PSenfft/pv_test_station/doc/partslist.md

# Parts list
- [ ] 1x (Adafruit Feather M0 LoRa Radio - 433MHz)[https://www.mouser.de/account/orders/detail?qs=Sn2QTPuoay%252BUEfD1VQ4ZfDkVjOmp3iWeccA1x4dP3mE%3d]
- [ ] 1x (Adafruit LoRa Radio Bonnet - 433MHz)[https://www.mouser.de/ProductDetail/485-4075]
- [ ] 1x Raspberry Pi 4
- [ ] 1x Current Sensor [CT426-HSN830DR](https://www.mouser.de/ProductDetail/462-CT426-HSN830DR)
- [ ] 2x [MCP9808 Temp Sensor Breakout Adafruit](https://www.mouser.de/ProductDetail/485-1782)
- [ ] 47K Resistor
- [ ] 3,3K Resistor
- [ ] 1uF capacitor (X5R)
- [ ] (Adafruit DS3231 Precision RTC)[https://www.mouser.de/ProductDetail/485-5188]
- [ ] I2C extender (LTC4311) [https://www.mouser.de/ProductDetail/485-4756]
- [ ] (433MHz Antenna db station) [https://www.mouser.de/ProductDetail/538-204287-0100]
- [ ] (433MHz Antenna dataminer)[https://www.mouser.de/ProductDetail/712-ANT-433-PW-QWUFL]
- [ ] (MPPT Controller (Off-Grid))[https://www.offgridtec.com/victron-smartsolar-mppt-75-15-15a-12v-24v-solar-laderegler.html]
- [ ] Dummyload ~500W immersion heaters
- [ ] (Relais 24V 20A) [https://www.digikey.de/de/products/detail/american-zettler/AZ576-1A-5DE/14307551]
- [ ] (Step Down DC/DC) [https://www.digikey.de/de/products/detail/dfrobot/DFR0571/9559261]
- [ ] PCB to Wire connector panel side min 43V 14A (Phoenic Contact 277-1579-ND)[https://www.digikey.de/de/products/detail/phoenix-contact/1017505/9346606]
- [ ] PCB to Wire connector load side min 24V 21A (Phoenic Contact 277-17516-ND)[https://www.digikey.de/de/products/detail/phoenix-contact/1017521/9346615]
- [ ] (Mosfet for  relias)[https://www.digikey.de/de/products/detail/onsemi/2N7002/244345]
- [ ] (FRAM)[https://www.digikey.de/de/products/detail/adafruit-industries-llc/1895/4990784]
