PSenfft/pv_test_station/pcb/pv_test_station/PV_measure_housing v4.3mf

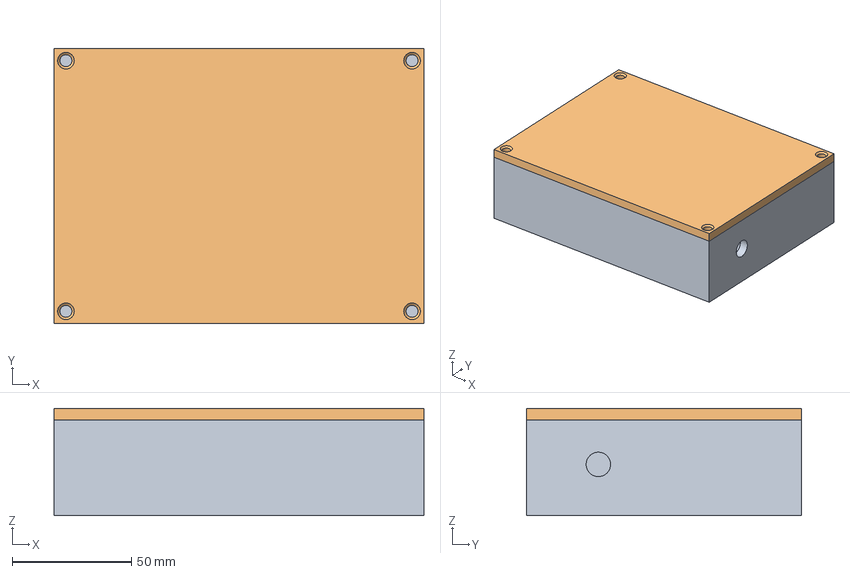
[picture p1: CAD file, 2025-01-16]
pcb/pv_test_station/PV_measure_housing v4.3mf
155.0 x 115.0 x 45.0 mm
Körper1
Körper5
