PSenfft/pv_test_station/pcb/pv_test_station/pv_test_station.3mf

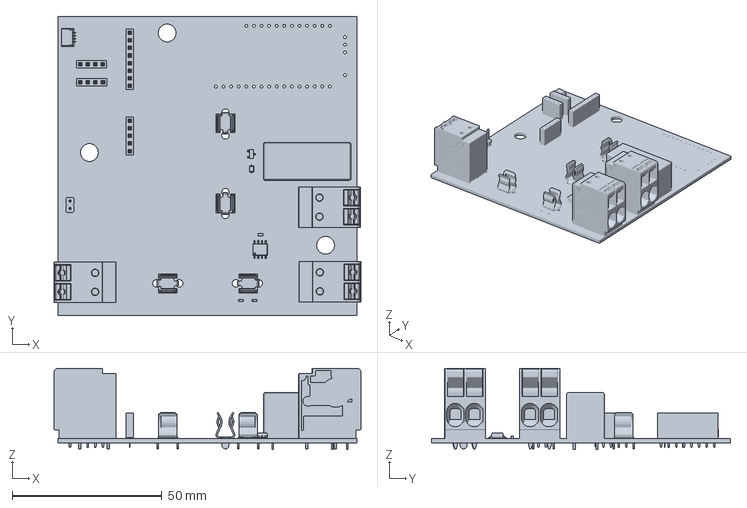
[picture p2: CAD file, 2025-01-16]
pcb/pv_test_station/pv_test_station.3mf
102.7 x 100.0 x 27.2 mm
