PSenfft/pv_test_station/pcb/pv_test_station/PV_measure_housing_rubber.3mf

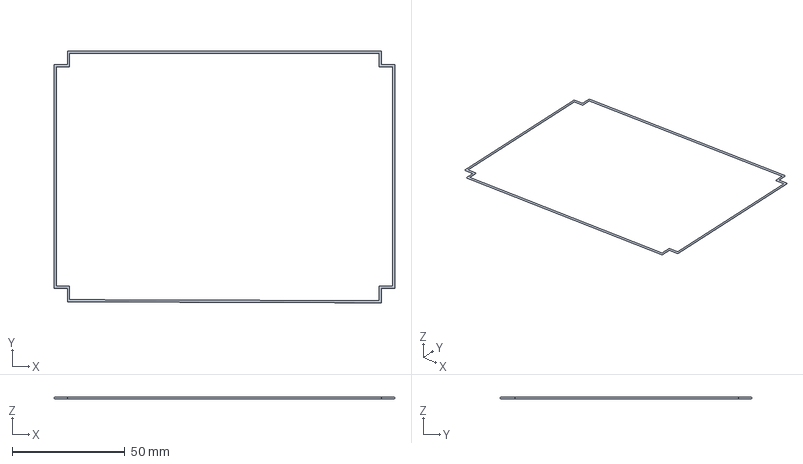
[picture p3: CAD file, 2025-01-16]
pcb/pv_test_station/PV_measure_housing_rubber.3mf
151.0 x 111.5 x 1.00 mm
