PSenfft/pv_test_station/pcb/pv_test_station/pv_test_station.kicad_pcb

## KiCad design pcb/pv_test_station/pv_test_station.kicad_pcb (2025-01-16)

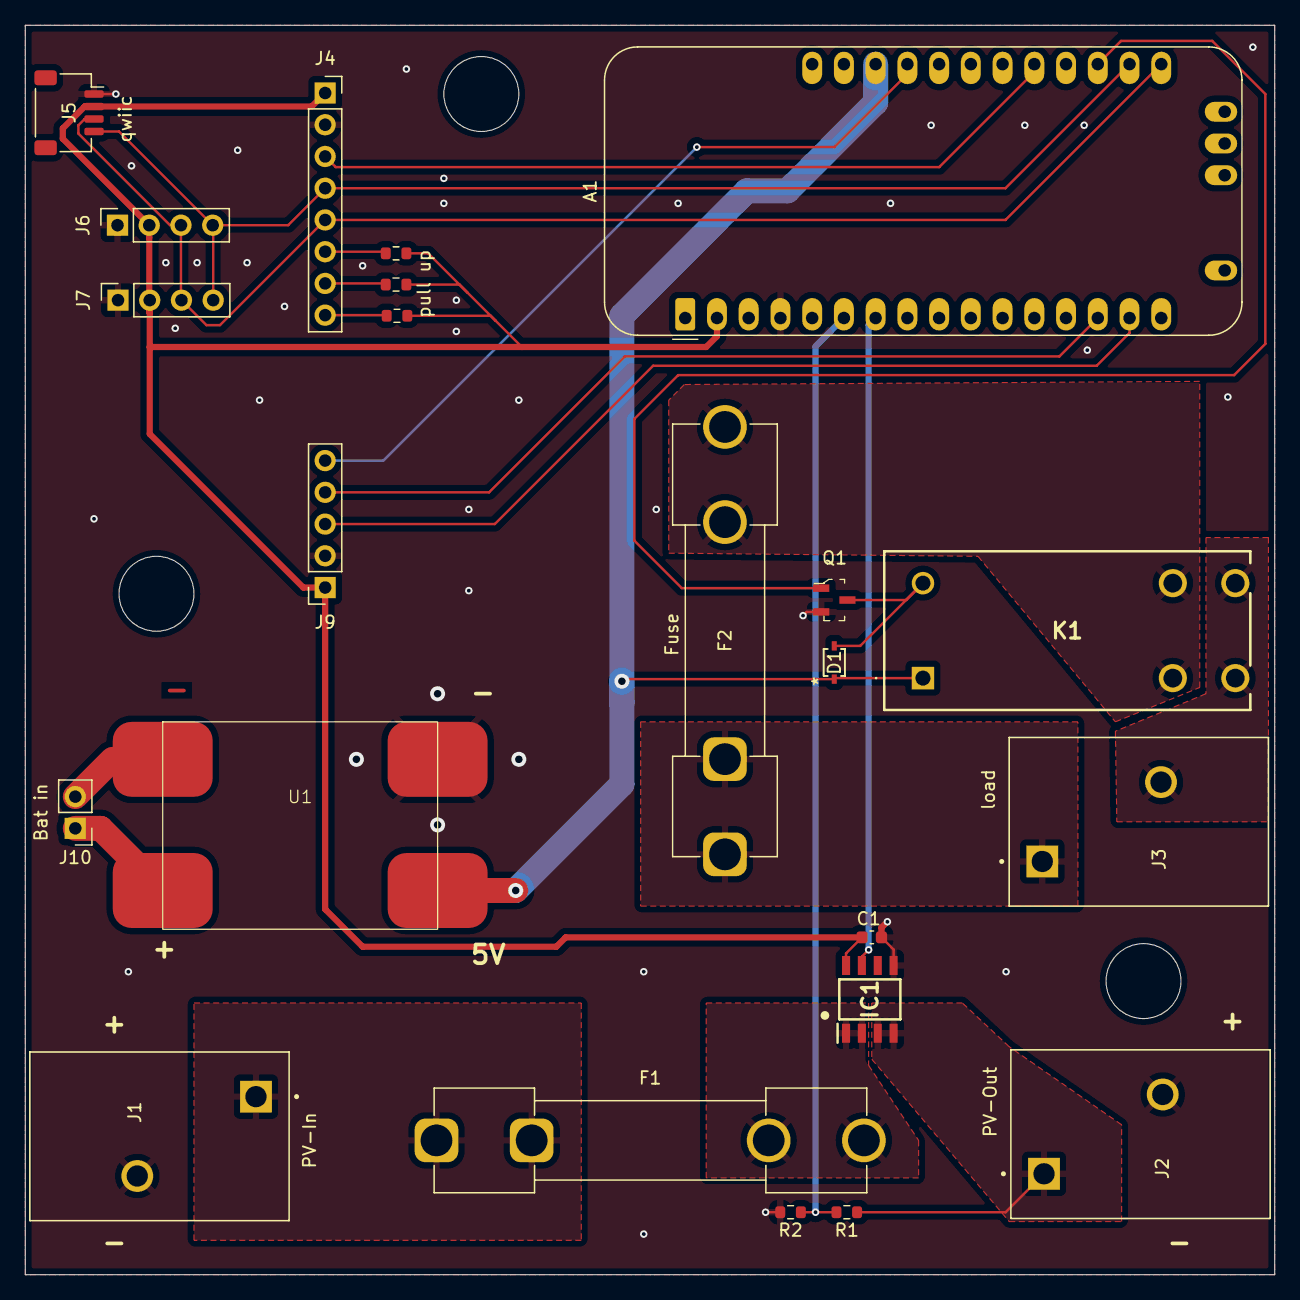
[picture p4: board pv_test_station.kicad_pcb from above]

Board: 2 copper layers, 100.0 x 100.0 mm, 23 parts (0 on the bottom side), 24 nets.

Parts:
A1: Adafruit_Feather_M0_RFM9x_LoRa_Radio; Adafruit_Feather_M0_RFM
C1: 1uF; C_0603_1608Metric
D1: D; DIODE_BAR6303WE6327HTSA1_INF
F1, F2: Fuse; Fuseholder_Clip-6.3x32mm_Littelfuse_102_Inline_P34.21x7.62m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
IC1: CT426-HSN830DR; SOIC127P600X172-8N
J1: PV-In; PHOENIX_1017521
J2: PV-Out; PHOENIX_1017521
J3: load; PHOENIX_1017521
J4: FRAM; PinSocket_1x08_P2.54mm_Vertical
J5: qwiic; JST_SH_SM04B-SRSS-TB_1x04-1MP_P1.00mm_Horizontal
J6: Temp1; PinSocket_1x04_P2.54mm_Vertical
J7: Temp2; PinSocket_1x04_P2.54mm_Vertical
J9: GPS; PinSocket_1x05_P2.54mm_Vertical
J10: Bat in; PinHeader_1x02_P2.54mm_Vertical
K1: AZ576-1A-12DE; AZ5761A12DE
Q1: 2N7002; SOT-23-3
R1: 100k; R_0603_1608Metric
R2: 8,33k; R_0603_1608Metric
R3, R4, R5: nc; R_0603_1608Metric
U1: DCDC

Connections:
+3.3V: A1.2 (3V3), C1.2, IC1.8 (VDD), J4.1, J5.2, J6.2, J7.2, J9.1, R3.2, R4.2, R5.2
+5V: A1.26 (USB), D1.1 (K), K1.1 (COIL_1), U1.4 (Vo+)
/+ In: F1.1, J1.1
/+ Out: IC1.3 (IP-_1), IC1.4 (IP-_2), J2.1, R1.1
/A_meter: A1.7 (A2), IC1.7 (OUT)
/PPS: A1.25 (D13), J9.5
/RX: A1.15 (TX/D1), J9.3
/RelaisPin: A1.19 (D5), Q1.1 (G)
/SCL: A1.18 (SCL/D21), J4.4, J5.4, J6.4, J7.4
/SDA: A1.17 (SDA/D20), J4.5, J5.3, J6.3, J7.3
/TX: A1.14 (RX/D0), J9.4
/V_meter: A1.6 (A1), R1.2, R2.1
/WP: A1.21 (D9), J4.3
GND: A1.4 (GND), C1.1, IC1.5 (GND), J1.2, J2.2, J4.2, J5.1, J6.1, J7.1, J9.2, Q1.2 (S), R2.2, U1.3 (Vo-)
unnamed: D1.2 (A), K1.2 (COIL_2), Q1.3 (D)
unnamed: F1.2, IC1.1 (IP+_1), IC1.2 (IP+_2)
unnamed: J3.2, K1.5 (NO_1), K1.8 (NO_2)
unnamed: J4.6, R3.1
unnamed: J4.7, R4.1
unnamed: J4.8, R5.1
unnamed: J10.1, U1.2 (Vi+)
unnamed: J10.2, U1.1 (Vi-)
unnamed: F2.2, K1.4 (COM_1), K1.7 (COM_2)
relais: F2.1, J3.1
