PSenfft/pv_test_station/(threads)

Thread 1 (2024-10-11):

Create PCB

PSenfft, 2024-10-11:
- [x] create schematic
- [ ]  switch i2c pin to rj45
- [ ]  crate PCB layout
- [ ] produce PCB

Closed 2025-01-11.
