PSenfft/pv_test_station/dataminer/src/main.cpp

#include "main.h"

RTC_DS3231 rtc;

// Create a buffer to hold the binary data
uint8_t buffer[11]; // 12 bits + 12 bits + 13 bits + 13 bits + 32 bits = ~82 bits = ~10.25 bytes, we use 8 bytes for alignment

float voltage = 0;        // voltage in V
float current = 0;        // current in A
float temp_env = 0.0;     // temperature in °C with 4 digits behind the comma
float temp_panel = 0.0;   // temperature in °C with 4 digits behind the comma
uint32_t timestamp = 0;

Flags flags = {0, 0, 0};

unsigned long currentMillis_temp_timer = 0;
unsigned long previousMillis_temp_timper = 0;

unsigned long currentMillis_rtc_time_sync = 0;
unsigned long previousMillis_rtc_time_sync = 0;

// --- iunterrupts ---
void pps_isr(){
  flags.pps_interrupt = 1;
}

//wakeup temp sensor when timer is over // has to be resetted after meassuring
void temp_sensor_wakeup_timer(){
  if (currentMillis_temp_timer - previousMillis_temp_timper >= SLEEPTIME_TEMP && flags.temp_sensor_wakeup_triggert == 0) {

    Serial.print("wakeup: ");
    Serial.println(millis());

    wakeup_temp_environment();
    wakeup_temp_panel();
    flags.temp_sensor_wakeup_triggert = 1;
  }
}

void reset_temp_sensor_wakeup_timer(){
  flags.temp_sensor_wakeup_triggert = 0;
  previousMillis_temp_timper = currentMillis_temp_timer; // Reset the timer
}

float read_voltage(){
  float adc_Value = analogRead(VOLTAGE_METER_PIN);
  float voltage = (adc_Value / ADC_MAX) * V_REF;
  return voltage;
}

//0.65V Voltage quicent
//2,65V sensor saturation
//Resulution 66.7mV/A
float read_current(){     
  float adc_Value = analogRead(CURRENT_METER_PIN);       //analog read 0-4095
  
  // return 0 if current is below 0.65V
  if (adc_Value < 807){
    return 0;
  }

  float voltage = (adc_Value / ADC_MAX) * MAX_VOLTAGE_PV; ;
  float current = ((voltage - V_OFFSET) / V_SPAN) * I_MAX;
  return current;                         //return current in A
}

void createPacket(uint8_t* packet) {
    // 1. Konvertiere Float-Werte in Network Byte Order
    uint32_t temp_env_network = htonl(*(uint32_t*)&temp_env);
    uint32_t temp_panel_network = htonl(*(uint32_t*)&temp_panel);
    uint32_t voltage_network = htonl(*(uint32_t*)&voltage);
    uint32_t current_network = htonl(*(uint32_t*)&current);
    
    // 2. Konvertiere den Timestamp in Network Byte Order
    uint32_t timestamp_network = htonl(timestamp);

    // 3. Kopiere die Werte ins Paket
    memcpy(packet, &temp_env_network, sizeof(uint32_t));
    memcpy(packet + sizeof(uint32_t), &temp_panel_network, sizeof(uint32_t));
    memcpy(packet + 2 * sizeof(uint32_t), &voltage_network, sizeof(uint32_t));
    memcpy(packet + 3 * sizeof(uint32_t), &current_network, sizeof(uint32_t));
    memcpy(packet + 4 * sizeof(uint32_t), &timestamp_network, sizeof(uint32_t));
}

void printPacket(uint8_t *packet, size_t length) {
  for (size_t i = 0; i < length; i++) {
    // Print each byte in hexadecimal
    Serial.print(packet[i], HEX);

    // Add a space between bytes for better readability
    Serial.print(" ");
  }
  Serial.println(); // Newline after printing the entire packet
}

void transmitData() {
    uint8_t package[20];  // 4 x float (16 Byte) 1 x uint32_t (4 Byte) -> 20 Byte
    createPacket(package);

    printPacket(package, sizeof(package));
    rf95.send(package, sizeof(package));
}

// Function to convert ISO 8601 date to Unix timestamp
time_t timestamp_to_unix(String iso_timestamp_string) {
    // Convert String to char array
  char iso_timestamp[iso_timestamp_string.length() + 1]; // +1 for null terminator
  iso_timestamp_string.toCharArray(iso_timestamp, iso_timestamp_string.length() + 1);

  struct tm t;
  memset(&t, 0, sizeof(struct tm));

  // Parsing the ISO 8601 string manually
  sscanf(iso_timestamp, "%4d-%2d-%2dT%2d:%2d:%2dZ", 
         &t.tm_year, &t.tm_mon, &t.tm_mday, 
         &t.tm_hour, &t.tm_min, &t.tm_sec);

  // Adjust year and month (tm_year is years since 1900, tm_mon is 0-based)
  t.tm_year -= 1900;
  t.tm_mon -= 1;

  // Convert to Unix time (seconds since Jan 1, 1970)
  time_t timestamp = mktime(&t);

  // Adjust for UTC, if necessary
  return timestamp;
}


//measure all sensors
void measure_everything(){
  voltage = read_voltage();
  current = read_current();
  temp_env = read_temp_environment();
  temp_panel = read_temp_panel();
  Serial.print("sleep now: ");
  Serial.println(millis());
  reset_temp_sensor_wakeup_timer();

  Serial.print("temp: ");
  Serial.println(temp_env, 4);

  timestamp = timestamp_to_unix(rtc.now().timestamp());
  
  Serial.print("time: ");
  Serial.println(timestamp);

  transmitData();
}

void sync_time(){
  if ((currentMillis_rtc_time_sync - previousMillis_rtc_time_sync >= TIME_SYNC_INTERVAL) && get_sat_amount() > 3) {
    if(flags.use_gps_time){
      rtc.adjust(DateTime(get_unix_time_from_gps()));
      Serial.println("Syncing time.. Sat: ");
      Serial.println(get_sat_amount());
    }
    previousMillis_rtc_time_sync = currentMillis_rtc_time_sync; // Reset the timer
  }
}

//check date
void check_timings(){
  // if no interrupt from PPS signal leave function
  if (!flags.pps_interrupt){ return;}

  //read gps and decide if gps or rtc time is to be used
  read_gps();
  //proof if gps time is valid otherwise set flag to use rtc time
  if(get_unix_time_from_gps() < POSSIBLE_TIME){
    flags.use_gps_time = 0; // GPS time is not valid use RTC time
  }else{
    flags.use_gps_time = 1; // GPS time is valid use GPS time
  }

  sync_time();
  measure_everything();
  //TODO set wachdog timer

  flags.pps_interrupt = 0;
}

void check_rtc_time_trigger(){
   if (currentMillis - previousMillis >= interval) {
    previousMillis = currentMillis; // Speichere die aktuelle Zeit
    flags.rtc_time_trigger = 1;

    // Debug-Ausgabe
    Serial.println("1 Sekunde vergangen, Flag gesetzt!");
   }
}

//TODO switch off relais, when Voltage is 1 min under 2V

void init_rtc(){
  if (! rtc.begin()) {
    Serial.println("Couldn't find RTC");
    Serial.flush();
    while (1) delay(10);
  }

  DateTime now = DateTime(F(__DATE__), F(__TIME__));
  // Subtract 2 hours for UTC adjustment
  now = now - TimeSpan(0, 2, 0, 0);  // TimeSpan(days, hours, minutes, seconds)

  rtc.adjust(now);
}

void setup() {
  //Pin setup
  pinMode(PPS_PIN, INPUT);
  pinMode(VOLTAGE_METER_PIN, INPUT);
  pinMode(CURRENT_METER_PIN, INPUT);
  attachInterrupt(PPS_PIN, pps_isr, RISING);

  //USB Serial
  Serial.begin(9600);

  init_rtc();
  init_temp();
  init_gps();
  init_lora();
}

void loop() {
  currentMillis_temp_timer = millis();
  currentMillis = millis();
  temp_sensor_wakeup_timer();
  check_rtc_time_trigger();
  
   if (flags.rtc_time_trigger) {
    measure_everything();
    flags.rtc_time_trigger = false;
   }
}
