PSenfft/pv_test_station/(commit log)

2024-09-13 added Temp sensor lib
2024-09-27 working on timer
2024-09-27 Adafruit Zerotimer is not supported. switch to other library
2024-10-04 something doesnt work with temp sensor
2024-10-11 created pcb
    [pv_test_station.kicad_pcb, pv_test_station.kicad_sch]
2024-10-14 reading temp sensor is working
2024-10-14 Update requirements.md
    switch partlist to own file
2025-01-10 finished pcb
    [pv_test_station.kicad_pcb, pv_test_station.kicad_sch]
2025-01-11 fixed some PCB issues (resistor size, GND on top layer)
    [pv_test_station.kicad_pcb, pv_test_station.kicad_sch]
2025-01-16 added docker for db
    [PV_measure_housing v4.3mf, PV_measure_housing_rubber.3mf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]
2025-01-16 made some fixes in db writer_mariaDB
    [db_wirter_mariaDB.py]
2025-01-17 last fixes before presentation
    [db_wirter_mariaDB.py, test_db_writer.py]
2025-01-20 changed some kicad files
